hsetlik/octaveEnv/simulations/HiPassRectThing.asc

C1: cap; 470n
C2: cap; 4.7n
C3: cap; 10n
C4: cap; 100n
C5: cap; 10n
C6: cap; 4.7n
C7: cap; 4.7n
C8: cap; 1n
D1: diode; 1N4148
D2: diode; 1N4148
D3: diode; 1N4148
D4: diode; 1N4148
Q1: pnp; BC857A
Q2: pnp; BC857A
R1: res; 4.7k
R2: res; 100k
R3: res; 680
R4: res; 680
R5: res; 4.7k
R6: res; 91k
R7: res; 2k7
R8: res; 470k
R9: res; 22k
R10: res; 100k
R11: res; 1.8k
R12: res; 100k
R13: res; 100k
R14: res; 100k
R15: res; 100k
R16: res; 50k
R17: res; 100k
R18: res; 100k
R19: res; 47k
R20: res; 47k
R21: res; 100k
R22: res; 47k
R23: res; 100k
R24: res; 100k
R25: res; 191k
R26: res; 100k
R27: res; 100k
R28: res; 100k
R29: res; 100k
R30: res; 50k
R31: res; 100k
R32: res; 47k
U1: LM13700
U2: LT1058
U3: LT1058
U4: LT1058
U5: 74hc74
U6: 74hc74
U7: LT1058
U8: LT1058
U9: LT1058
U10: LT1058
U11: LT1058
U12: LT1058
U13: LT1058
V1: voltage; SINE(0 0.4 85)
V2: voltage; 9
V3: voltage; 9
V4: voltage; PULSE(0 3.3 500m 10m 60m 60m 130m 1)
V5: voltage; 5
Named nets: 0, +9, -9, BASS, vcc, SQR1, edge, Rect1, HP1, HP2, Rect2, SQR2
.tran 700m 500m
.INCLUDE CD4000.lib
.INCLUDE 74HC.lib
.lib lm13700.sub
Ignore this it's just a convenient way to simulate a guitar signal
.lib CD4046Bg.sub
