hsetlik/octaveEnv/simulations/OctaveUpSim.asc

C1: cap; 470n
C2: cap; 4.7n
C3: cap; 100n
C4: cap; 100n
C5: cap; 1µ
C6: cap; 470n
C7: cap; 1n
C8: cap; 1n
D1: diode
D2: diode
D3: diode
Q1: pnp; BC857A
Q2: pnp; BC857A
Q3: pnp; BC857A
R1: res; 4.7k
R2: res; 100k
R3: res; 680
R4: res; 680
R5: res; 4.7k
R6: res; 91k
R7: res; 2k7
R8: res; 470k
R9: res; 22k
R10: res; 33k
R11: res; 47k
R12: res; 100k
R13: res; 100k
R14: res; 1
R15: res; 99.99k
R16: res; 680
R17: res; 22k
R18: res; 22k
R19: res; 99k
R20: res; 33k
R21: res; 100k
R22: res; 47k
R23: res; 4.7k
R24: res; 100k
R25: res; 680
R26: res; 680
R27: res; 47k
R28: res; 100k
R29: res; 470
R30: res; 6.8k
R31: res; 10k
R32: res; 68k
R33: res; 220k
R34: res; 1k
R35: res; 1k
R36: res; 22k
R37: res; 1
R39: res; 99.9k
R40: res; 100k
R41: res; 100k
R42: res; 100k
R43: res; 470
U1: LM13700
U2: LT1058
U3: LT1058
U4: LT1058
U5: 74hc74
U6: 74hc74
U7: LT1058
U8: LT1058
U9: LT1058
U10: LT1058
U11: LM13700
U12: LT1058
U13: LT1058
U14: LT1058
U15: LT1058
V1: voltage; SINE(0 0.1 440)
V2: voltage; 9
V3: voltage; 9
V4: voltage; PULSE(0 3.3 0 10m 60m 30m 100m 1)
V5: voltage; 5
Named nets: 0, +9, -9, GTR, edge, vcc, SQR1, SQR2, ENV, OCT_FULL, OUT, GTR_GAIN
.tran 200m UIC
.INCLUDE CD4000.lib
.INCLUDE 74HC.lib
.lib lm13700.sub
Ignore this it's just a convenient way to simulate a guitar signal
R14 and R15 act as a blend pot
R16 = attack time
R17 = release time
R19 (100k pot) controls envelope gain
R32 is the main tone control
Note: Smaller caps for c3 and c4 act as high passes such that we 
get a sort of sawtooth shape for the freq range in question
