hsetlik/octaveEnv/OctaveEnv.kicad_pcb

## KiCad design OctaveEnv.kicad_pcb (2025-01-12)

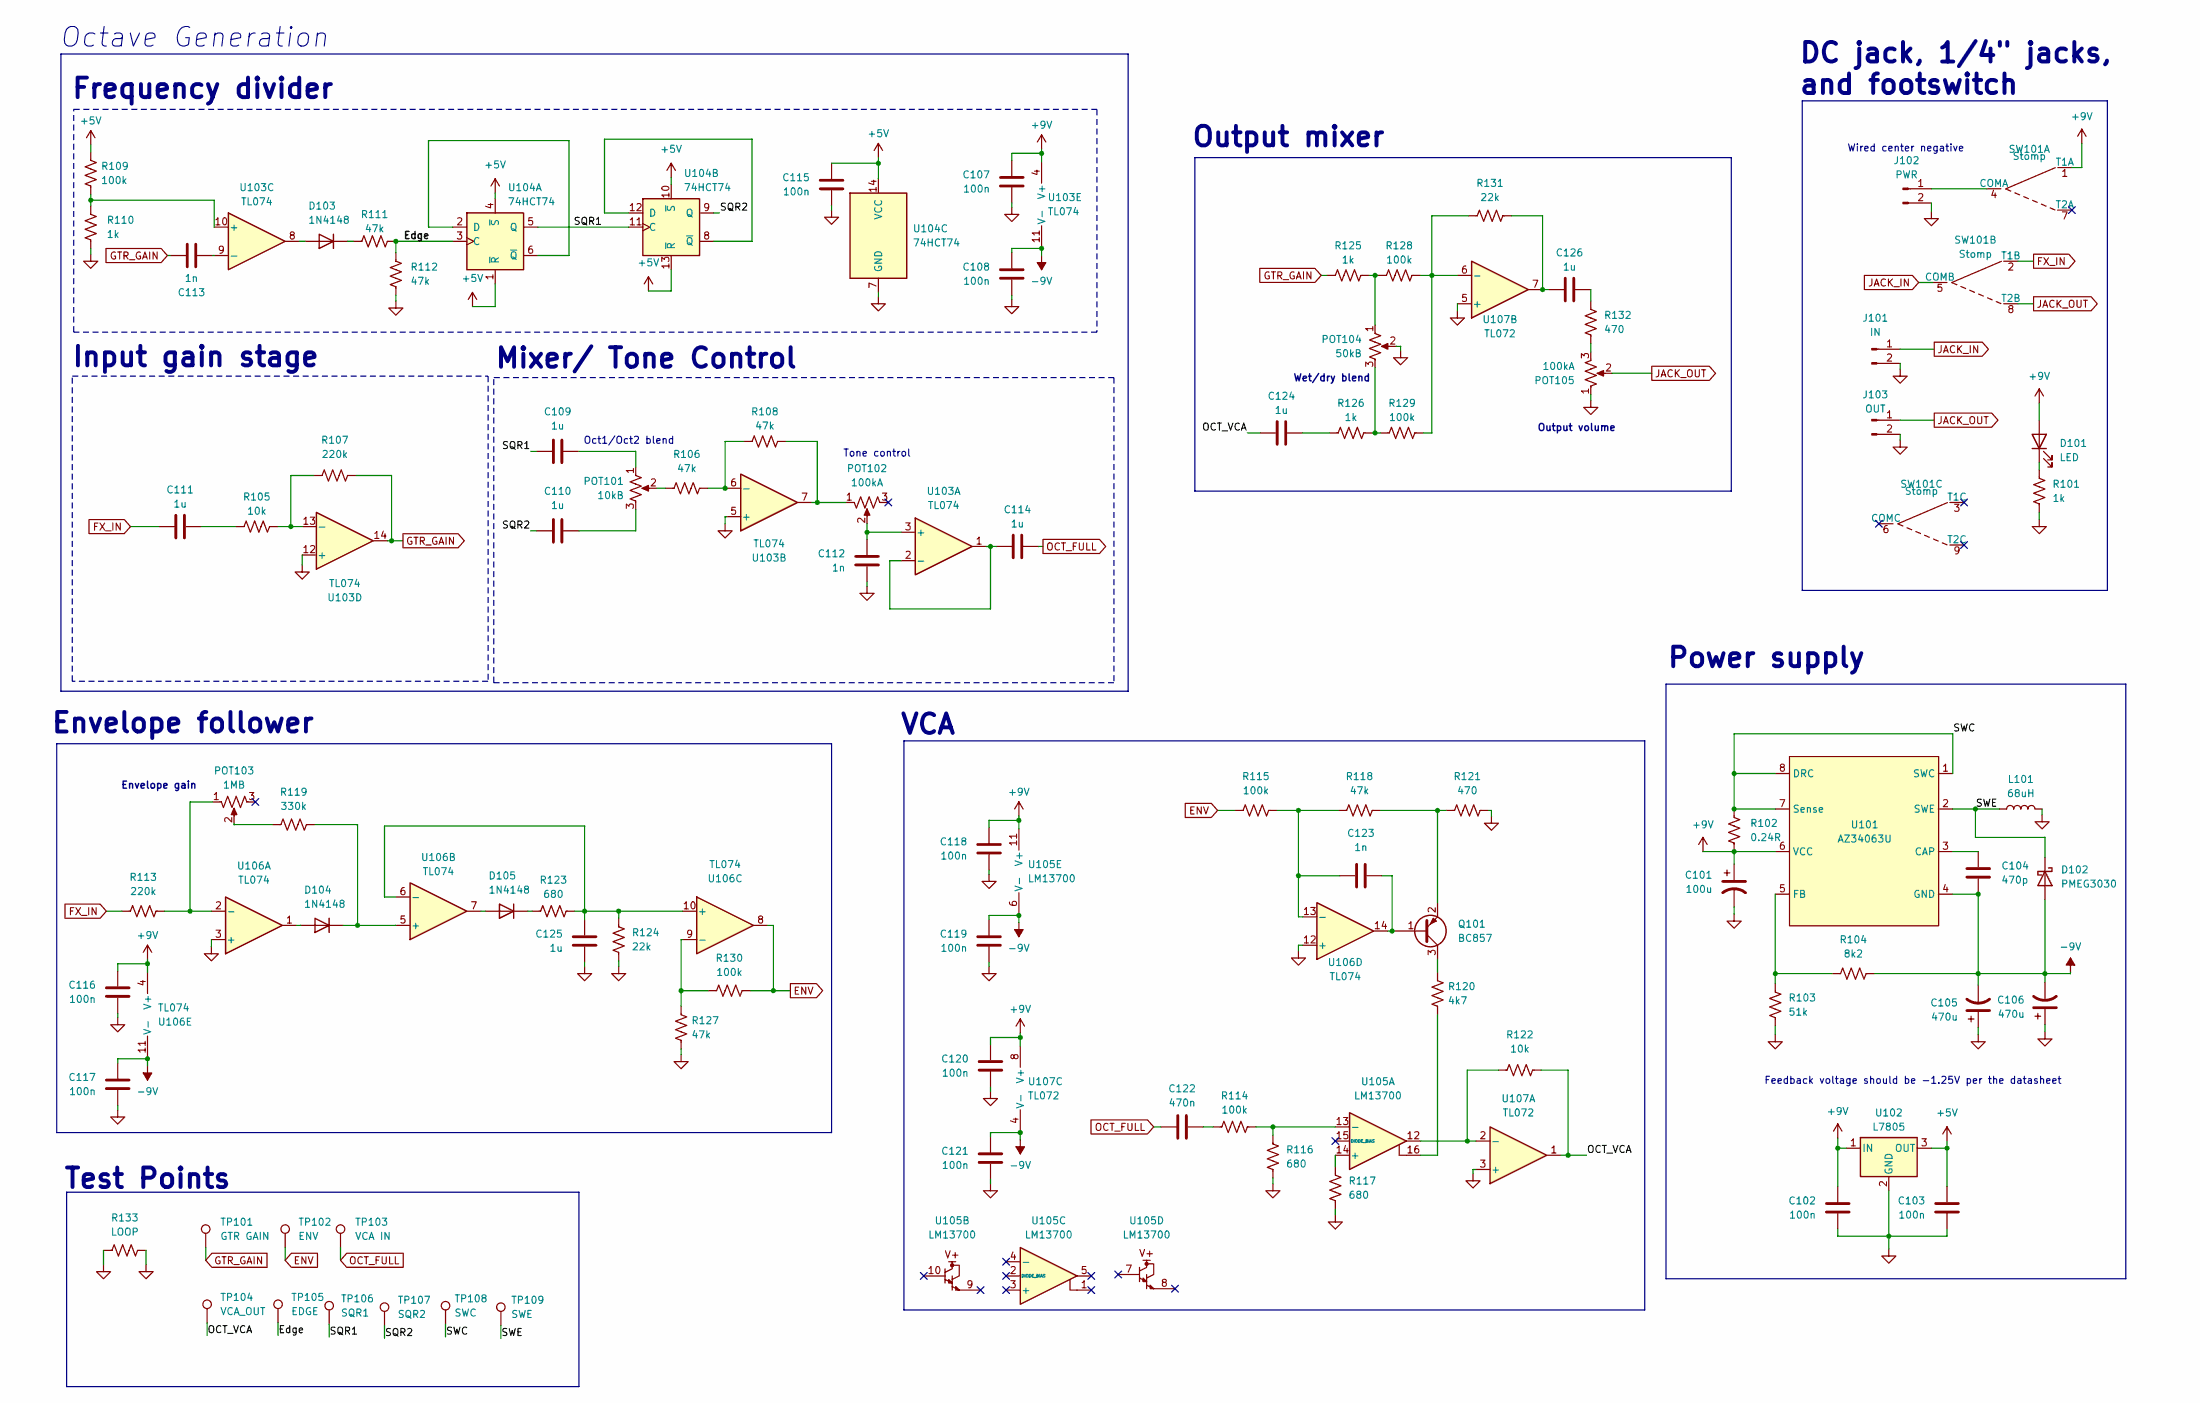
[picture p1: schematic OctaveEnv.kicad_sch]

Parts:
C101: 100u; CP_Radial_D5.0mm_P2.00mm
C102, C103, C107, C108, C115, C116, C117, C118, C119, C120, C121: 100n; C_0805_2012Metric
C104: 470p; C_0805_2012Metric
C105, C106: 470u; CP_Radial_D5.0mm_P2.00mm
C109, C110, C111, C114, C124, C125, C126: 1u; C_0805_2012Metric
C112, C113, C123: 1n; C_0805_2012Metric
C122: 470n; C_0805_2012Metric
D101: LED; LED_D3.0mm
D102: PMEG3030; D_SOD-123
D103, D104, D105: 1N4148; D_SOD-123
J101: IN; PinHeader_1x02_P2.54mm_Vertical
J102: PWR; PinHeader_1x02_P2.54mm_Vertical
J103: OUT; PinHeader_1x02_P2.54mm_Vertical
L101: 68uH; L_TDK_VLS6045EX_VLS6045AF
POT101: 10kB; Potentiometer_Alpha_RD901F-40-00D_Single_Vertical
POT102, POT105: 100kA; Potentiometer_Alpha_RD901F-40-00D_Single_Vertical
POT103: 1MB; Potentiometer_Alpha_RD901F-40-00D_Single_Vertical
POT104: 50kB; Potentiometer_Alpha_RD901F-40-00D_Single_Vertical
Q101: BC857; SOT-23
R101, R110, R125, R126: 1k; R_0805_2012Metric
R102: 0.24R; R_0805_2012Metric
R103: 51k; R_0805_2012Metric
R104: 8k2; R_0805_2012Metric
R105, R122: 10k; R_0805_2012Metric
R106, R108, R111, R112, R118, R127: 47k; R_0805_2012Metric
R107, R113: 220k; R_0805_2012Metric
R109, R114, R115, R128, R129, R130: 100k; R_0805_2012Metric
R116, R117, R123: 680; R_0805_2012Metric
R119: 330k; R_0805_2012Metric
R120: 4k7; R_0805_2012Metric
R121, R132: 470; R_0805_2012Metric
R124, R131: 22k; R_0805_2012Metric
R133: LOOP; R_Axial_DIN0207_L6.3mm_D2.5mm_P7.62mm_Horizontal
SW101: Stomp; StompSwitchBreakout_P200
TP101: GTR GAIN; TestPoint_THTPad_D1.5mm_Drill0.7mm_VAL
TP102: ENV; TestPoint_THTPad_D1.5mm_Drill0.7mm_VAL
TP103: VCA IN; TestPoint_THTPad_D1.5mm_Drill0.7mm_VAL
TP104: VCA_OUT; TestPoint_THTPad_D1.5mm_Drill0.7mm_VAL
TP105: EDGE; TestPoint_THTPad_D1.5mm_Drill0.7mm_VAL
TP106: SQR1; TestPoint_THTPad_D1.5mm_Drill0.7mm_VAL
TP107: SQR2; TestPoint_THTPad_D1.5mm_Drill0.7mm_VAL
TP108: SWC; TestPoint_THTPad_D1.5mm_Drill0.7mm_VAL
TP109: SWE; TestPoint_THTPad_D1.5mm_Drill0.7mm_VAL
U101: AZ34063U; SO-8_3.9x4.9mm_P1.27mm
U102: L7805; TO-220-3_Vertical
U103, U106: TL074; SOIC-14_3.9x8.7mm_P1.27mm
U104: 74HCT74; SO-14_3.9x8.65mm_P1.27mm
U105: LM13700; SOIC-16_3.9x9.9mm_P1.27mm
U107: TL072; SOIC-8_3.9x4.9mm_P1.27mm

Connections:
+5V: C103.1, C115.1, R109.1, U102.3 (OUT), U104.1 (~R), U104.4 (~S), U104.10 (~S), U104.13 (~R), U104.14 (VCC)
+9V: C101.1, C102.1, C107.1, C116.1, C118.1, C120.1, D101.2 (A), R102.1, SW101.1 (T1A), U101.6 (VCC), U102.1 (IN), U103.4 (V+), U105.11 (V+), U106.4 (V+), U107.8 (V+)
-9V: C104.2, C105.2, C106.2, C108.1, C117.1, C119.1, C121.1, D102.2 (A), R104.2, U101.4 (GND), U103.11 (V-), U105.6 (V-), U106.11 (V-), U107.4 (V-)
/Edge: R111.2, R112.1, TP105.1, U104.3 (C)
/OCT_VCA: C124.1, R122.2, TP104.1, U107.1
/SQR1: C109.1, TP106.1, U104.5 (Q), U104.11 (C)
/SQR2: C110.1, TP107.1, U104.9 (Q)
/SWC: R102.2, TP108.1, U101.1 (SWC), U101.7 (Sense), U101.8 (DRC)
/SWE: D102.1 (K), L101.1, TP109.1, U101.2 (SWE)
ENV: R115.1, R130.2, TP102.1, U106.8
FX_IN: C111.1, R113.1, SW101.2 (T1B)
GND: C101.2, C102.2, C103.2, C105.1, C106.1, C107.2, C108.2, C112.2, C115.2, C116.2, C117.2, C118.2, C119.2, C120.2, C121.2, C125.2, J101.2, J102.2, J103.2, L101.2, POT104.2, POT105.1, R101.1, R103.1, R110.2, R112.2, R116.2, R117.2, R121.2, R124.2, R127.2, R133.1, R133.2, U102.2 (GND), U103.5 (+), U103.12 (+), U104.7 (GND), U106.3 (+), U106.12 (+), U107.3 (+), U107.5 (+)
GTR_GAIN: C113.1, R107.2, R125.1, TP101.1, U103.14
JACK_IN: J101.1, SW101.5 (COMB)
JACK_OUT: J103.1, POT105.2, SW101.8 (T2B)
unnamed: C109.2, POT101.1
unnamed: C110.2, POT101.3
unnamed: C111.2, R105.1
unnamed: C122.2, R114.1
unnamed: C124.2, R126.1
unnamed: C126.1, R131.2, U107.7
unnamed: C126.2, R132.1
unnamed: D101.1 (K), R101.2
unnamed: D103.2 (A), U103.8
unnamed: D103.1 (K), R111.1
unnamed: D104.2 (A), U106.1
unnamed: D104.1 (K), R119.2, U106.5 (+)
unnamed: D105.2 (A), U106.7
unnamed: D105.1 (K), R123.1
unnamed: J102.1, SW101.4 (COMA)
unnamed: POT101.2, R106.1
unnamed: POT102.1, R108.2, U103.7
unnamed: POT103.2, R119.1
unnamed: POT104.1, R125.2, R128.1
unnamed: POT104.3, R126.2, R129.1
unnamed: POT105.3, R132.2
unnamed: C123.2, Q101.1 (B), U106.14
unnamed: Q101.3 (C), R120.1
unnamed: Q101.2 (E), R118.2, R121.1
unnamed: R120.2, U105.16
unnamed: C104.1, U101.3 (CAP)
unnamed: R103.2, R104.1, U101.5 (FB)
unnamed: C112.1, POT102.2, U103.3 (+)
unnamed: C114.1, U103.1, U103.2 (-)
unnamed: R106.2, R108.1, U103.6 (-)
unnamed: R109.2, R110.1, U103.10 (+)
unnamed: C113.2, U103.9 (-)
unnamed: R105.2, R107.1, U103.13 (-)
unnamed: U104.2 (D), U104.6 (~Q)
unnamed: U104.8 (~Q), U104.12 (D)
unnamed: R117.1, U105.14 (+)
unnamed: R114.2, R116.1, U105.13 (-)
unnamed: POT103.1, R113.2, U106.2 (-)
unnamed: C125.1, R123.2, R124.1, U106.6 (-), U106.10 (+)
unnamed: R127.1, R130.1, U106.9 (-)
unnamed: C123.1, R115.2, R118.1, U106.13 (-)
unnamed: R122.1, U105.12, U107.2 (-)
unnamed: R128.2, R129.2, R131.1, U107.6 (-)
OCT_FULL: C114.2, C122.1, TP103.1

Notes on the sheet:
DC jack, 1/4" jacks, and footswitch
Envelope follower
Tone control
Output volume
Feedback voltage should be -1.25V per the datasheet
Frequency divider
Wet/dry blend
Octave Generation
Mixer/ Tone Control
Input gain stage
Envelope gain
VCA
Output mixer
Power supply
Test Points
Wired center negative
Oct1/Oct2 blend

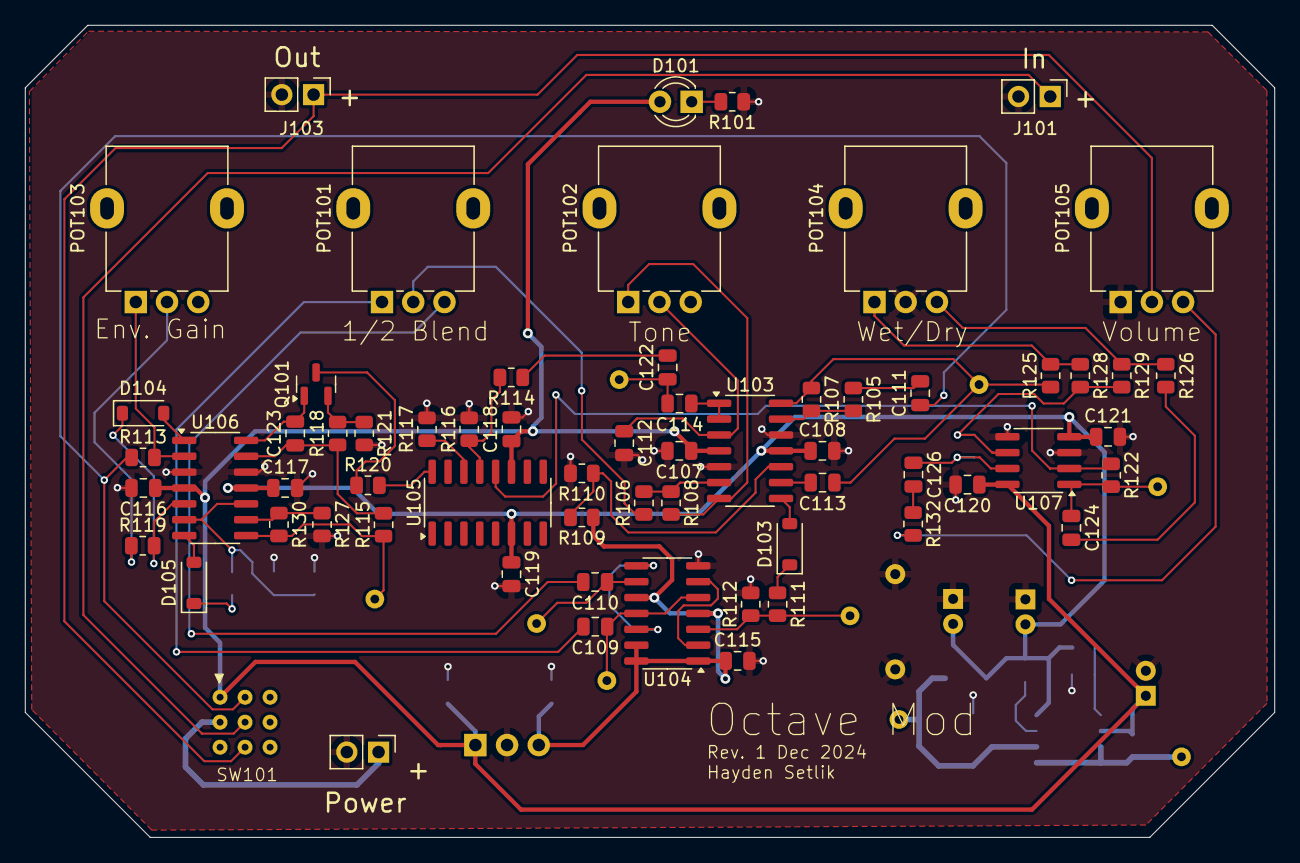
[picture p2: board OctaveEnv.kicad_pcb from above]

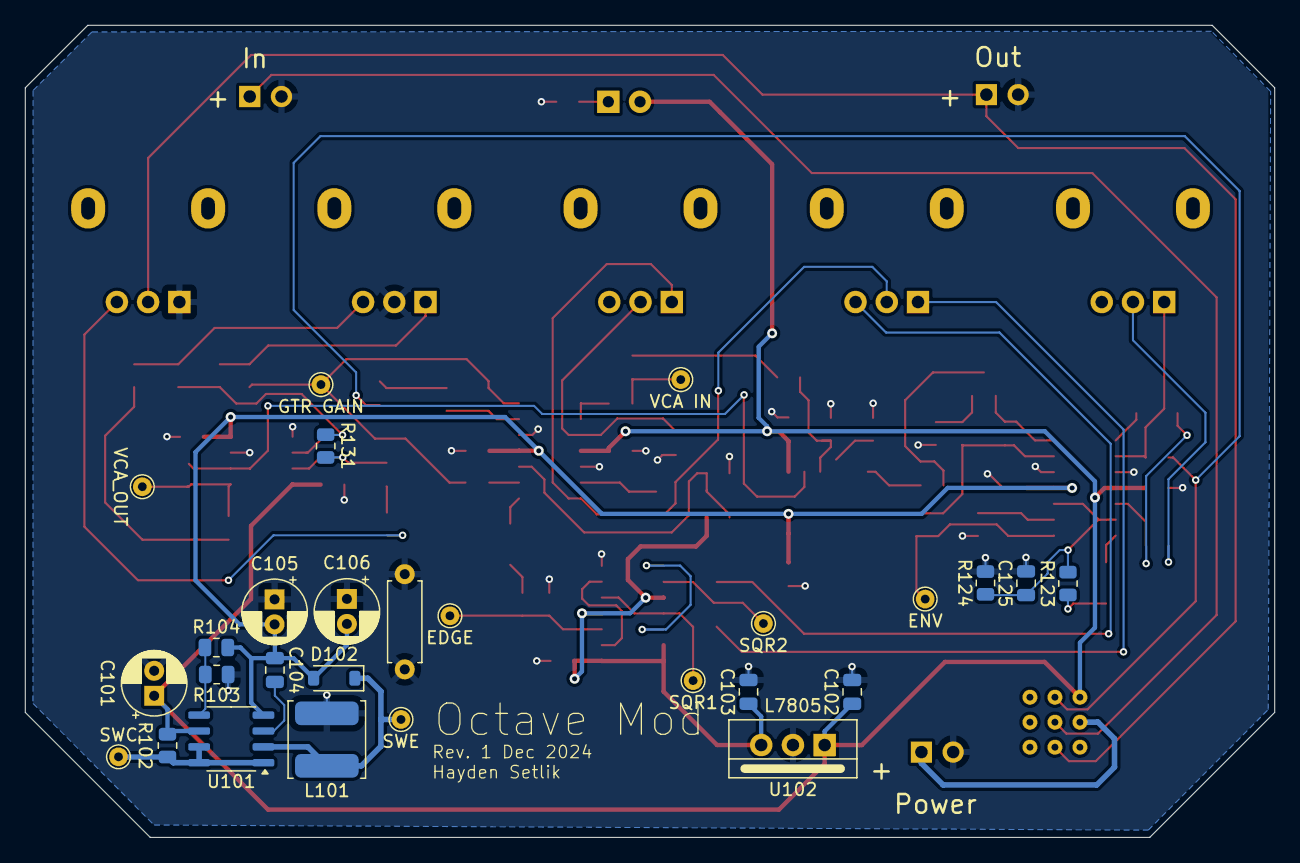
[picture p3: board OctaveEnv.kicad_pcb from below]

Board: 4 copper layers, 100.0 x 65.0 mm, 91 parts (27 on the bottom side), 59 nets.
