hsetlik/octaveEnv/(commit log)

2024-12-02 spice sim, start of schematic
    [EnvFollower.kicad_sch, OctaveEnv.kicad_sch, OctaveGen.kicad_sch, PowerSupply.kicad_sch]
2024-12-03 finished and consolidated schem
    [EnvFollower.kicad_sch, OctaveEnv.kicad_sch, OctaveGen.kicad_sch, PowerSupply.kicad_sch]
2024-12-03 footprints assigned, ERC passing
    [OctaveEnv.kicad_sch]
2024-12-04 layout start
    [OctaveEnv.kicad_pcb, OctaveEnv.kicad_sch]
2024-12-06 layout done
    [OctaveEnv.kicad_pcb]
2024-12-06 routing and test points
    [OctaveEnv.kicad_pcb, OctaveEnv.kicad_sch]
2024-12-07 smaller outline
    [OctaveEnv.kicad_pcb, OctaveEnv.kicad_sch]
2024-12-07 silkscreen stuff, new layout
    [OctaveEnv.kicad_pcb]
2024-12-07 new routing started
    [OctaveEnv.kicad_pcb]
2024-12-07 routing done, DRC passing
    [OctaveEnv.kicad_pcb]
2024-12-07 rev1 gerbers ready
    [OctaveEnv.kicad_pcb]
2024-12-08 rev1 sent to fab
    [OctaveEnv.kicad_pcb, OctaveEnv.kicad_sch]
2024-12-10 added bom
2025-01-12 octave up sim
    [OctaveEnv.kicad_pcb, OctaveEnv.kicad_sch]
